arkku/burner/burner_schematic.pdf

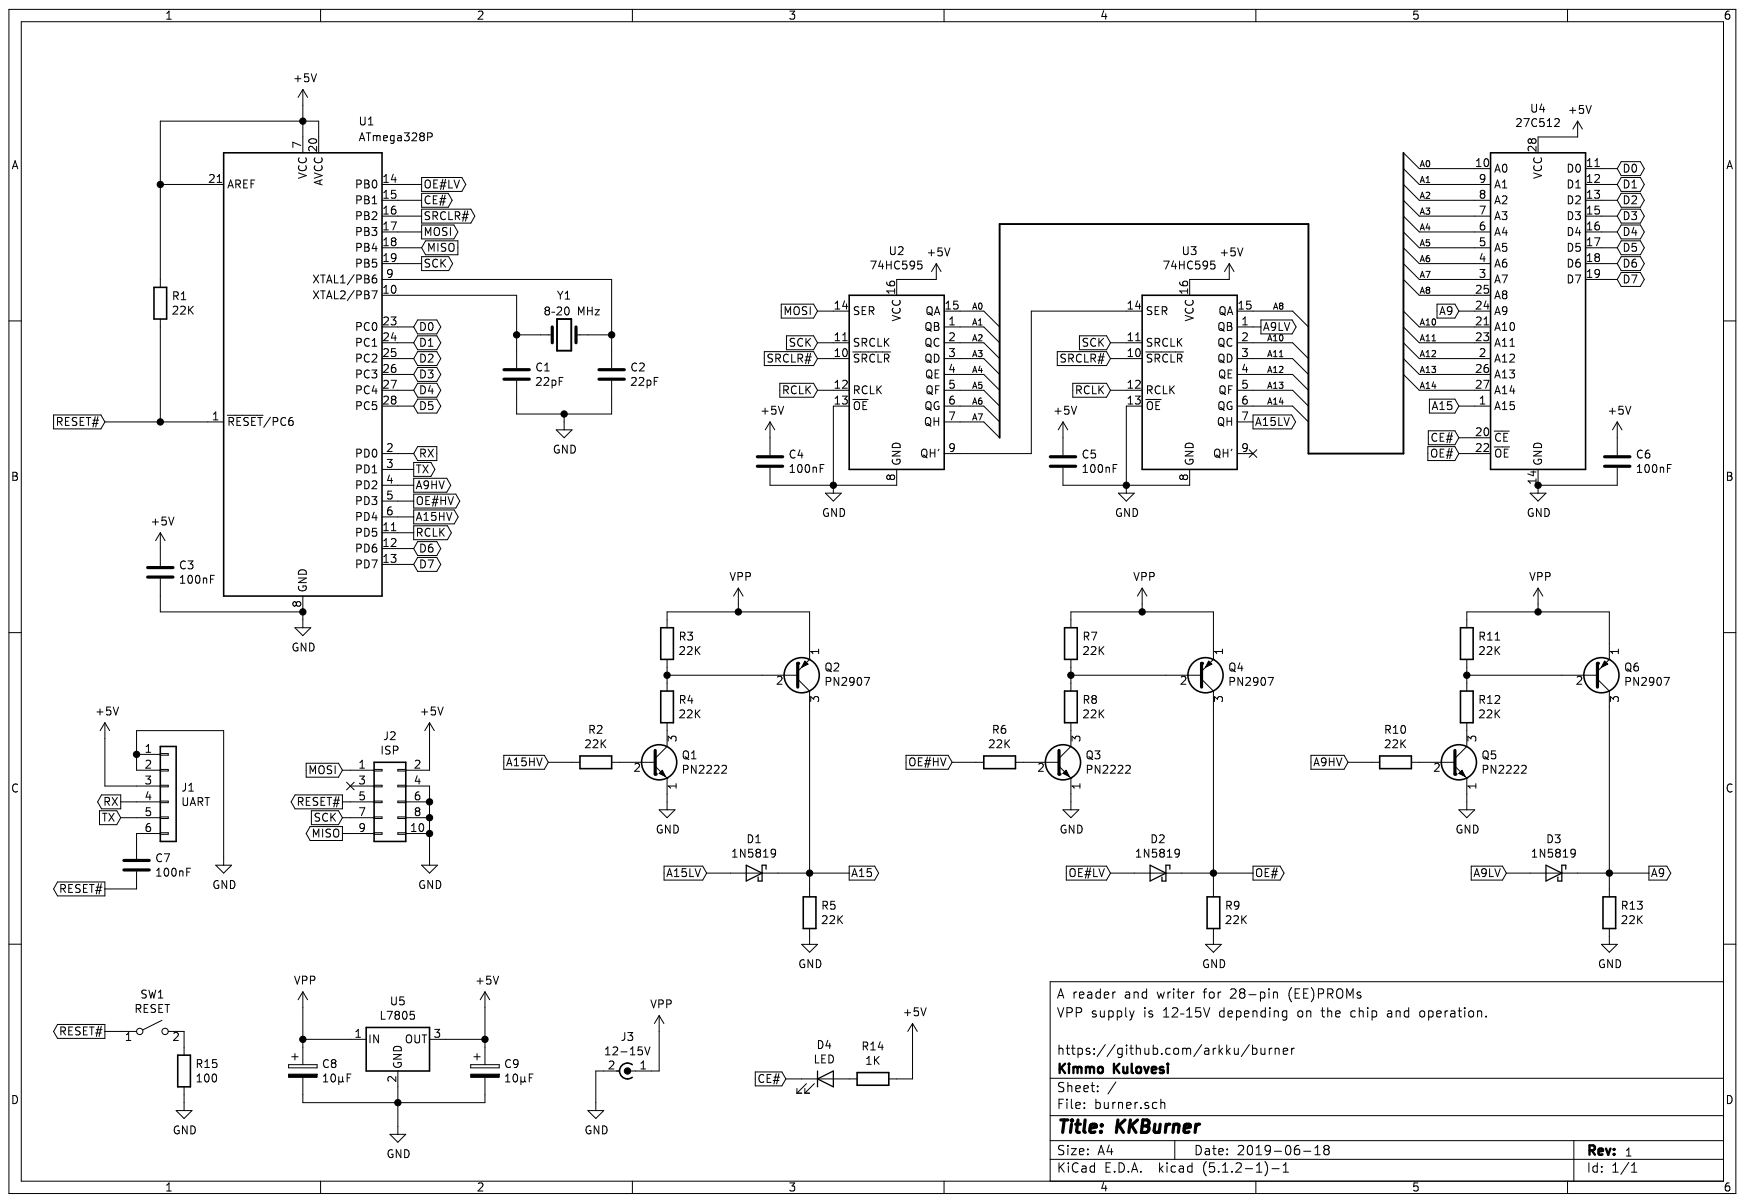
[picture p1: page 1]
