arkku/burner/burner.sch

## KiCad design burner.sch (2019-06-18, last stored version)

Schematic: burner.sch

Parts:
C1, C2: 22pF; C_Disc_D5.0mm_W2.5mm_P2.50mm
C3, C4, C5, C6, C7: 100nF; C_Axial_L5.1mm_D3.1mm_P10.00mm_Horizontal
C8, C9: 10µF; CP_Radial_D7.5mm_P2.50mm
D1, D2, D3: 1N5819; D_DO-41_SOD81_P10.16mm_Horizontal
D4: LED; LED_D5.0mm
J1: UART; PinHeader_1x06_P2.54mm_Vertical
J2: ISP; IDC-Header_2x05_P2.54mm_Vertical
J3: PWR; BarrelJack_Horizontal
Q1, Q3, Q5: PN2222; TO-92_Inline
Q2, Q4, Q6: PN2907; TO-92_Inline
R1, R2, R3, R4, R5, R6, R7, R8, R9, R10, R11, R12: 22K; R_Axial_DIN0411_L9.9mm_D3.6mm_P5.08mm_Vertical
R13: 1K; R_Axial_DIN0411_L9.9mm_D3.6mm_P5.08mm_Vertical
R14: 100; R_Axial_DIN0411_L9.9mm_D3.6mm_P5.08mm_Vertical
SW1: RESET; SW_PUSH_6mm
U1: ATmega328P-PU; DIP-28_W7.62mm_Socket
U2, U3: 74HC595; DIP-16_W7.62mm
U4: 27C512; DIP-28_W15.24mm_Socket
U5: L7805; TO-220-4_Vertical
Y1: 8–20 MHz; Crystal_HC49-U_Vertical

Notes on the sheet:
KKBurner
2019-06-17
A reader and writer for 28-pin EEPROMs, such as 27SF512 and W27C512.
See https://github.com/arkku/burner
VPP supply is 12-15V depending on the chip and operation.
© 2019 Kimmo Kulovesi, arkku.com
