arkku/burner/(commit log)

2019-06-16 Fix and clarify docs
    [burner.c]
2019-06-17 Fix typos in docs, add schematic
    [kk_uart.c, kk_uart.h]
2019-06-17 Clean up schematic
2019-06-18 Add schematic .sch file
    [burner.sch]
2019-06-18 Update schematic, delete .sch for now
    [burner.sch]
2019-06-21 Add last rx error status, fix buffer size check
    [kk_uart.c, kk_uart.h]
2019-06-21 Re-enable shared buffer, fix one PSTR
    [burner.c]
2019-08-07 Support 5V programmable chips, add diagnostics
